mark-fyq/BEIDOU-project/README.md

# BEIDOU-project
一个神奇的计划！

天权-STM32最小核心系统板
