mark-fyq/BEIDOU-project/tianquan/V1.0/README-tianquan.md

# 项目介绍
一个STM32F103C8T6/STM32F103C6T6的超小型核心板，采用M.2-M接口，能够极大方便项目硬件移植以及简化电路设计。（仅成功烧录程序，未进行功能验证）

# 项目说明
* 已上传的文件包括核心板原理图、PCB、M.2接口的封装（AD）。  

# 注意事项
* 核心板打板请选择板厚==0.8mm==、绿色，并备注：不做半孔工艺（土豪无所谓）==PS：一般工艺都是焊盘镀锡，插拔次数有限！==
* 核心板PCB设计按照回流焊工艺（实际用热风枪吹），所以没有预留手焊空间。
* 有可能会出现PCB与原理图相差的地方，一切以PCB为准。
* 晶振要注意匹配电容不一定是12PF，购买时注意商家的备注。
* 轻触开关尺寸为3X4X2.5（应该没有比这个更小尺寸的得了）。
* 想重画PCB的注意M.2接口附近2mm内的TOP和BOTTOM层不做铺铜，防止因有可能的剐蹭造成的短路。

# 项目进度
* 原理设计（√）  
* LAYOUT设计（√）  
* PCB打板及焊接（√）
* 程序烧录验证（√）
* 转接底板设计
* 转接底板PCB打板及焊接
* 全功能及验证

# 核心板硬件功能
* SW下载接口
* 5V转3V3电源转换
* 串口转USB
* 16MBit SPI FLASH
* 电源、串口通信指示灯
* 复位按键

# 核心板实物图
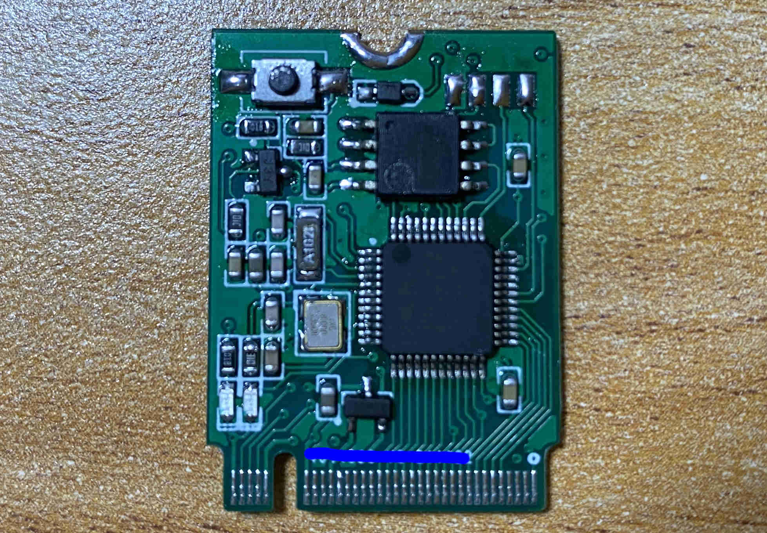
[picture p1: tianquan/V1.0/实物图/封面1.jpg]




# 附加说明
如有错误之处欢迎指正！
