mark-fyq/BEIDOU-project/tianquan/V1.0/实物图/原理图7.png

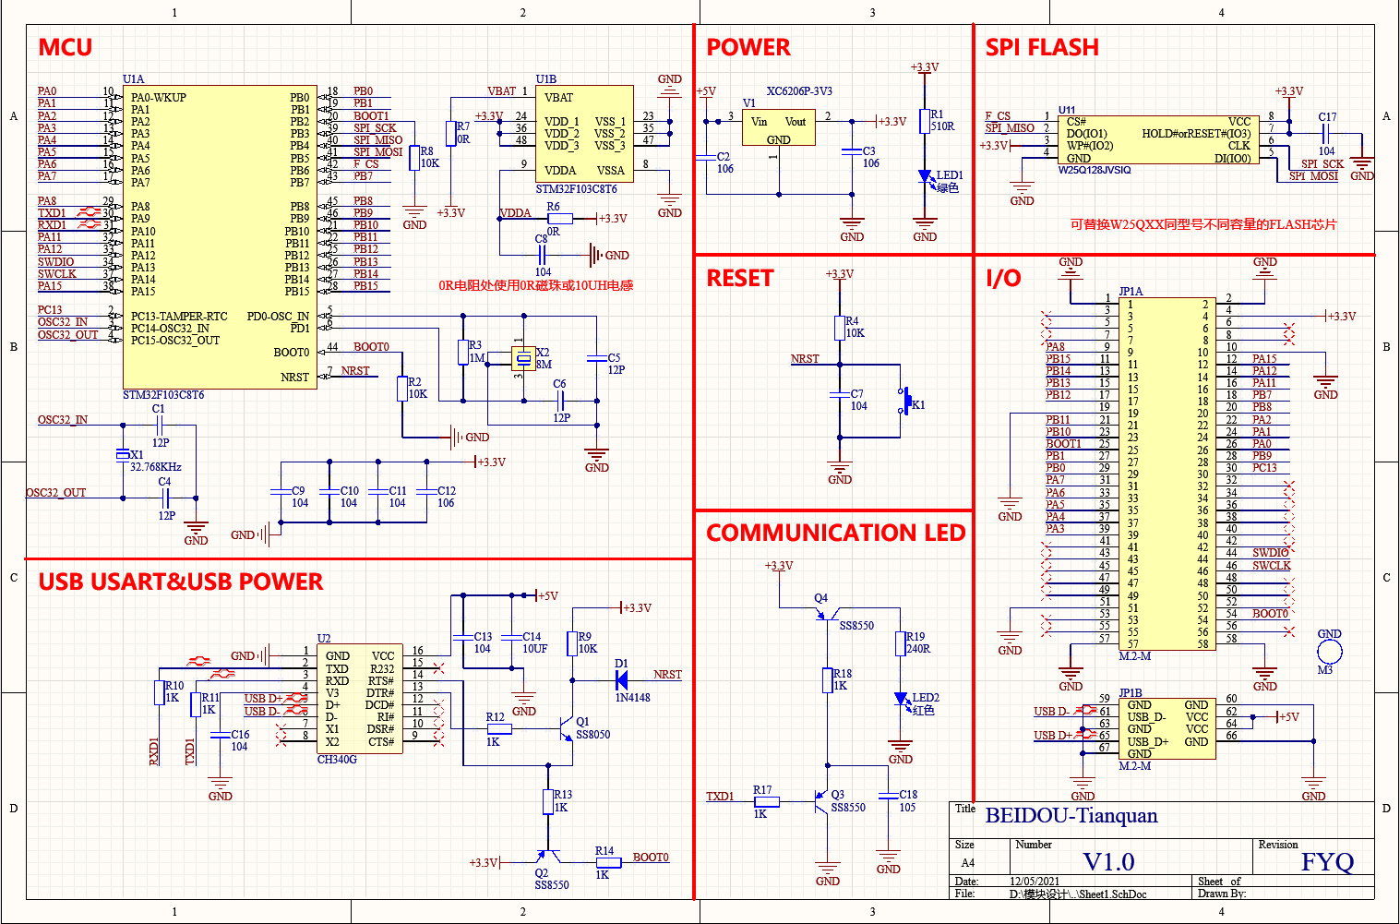
tianquan/V1.0/实物图/原理图7.png
