mark-fyq/BEIDOU-project/tianquan/V1.0/实物图/测试6.png

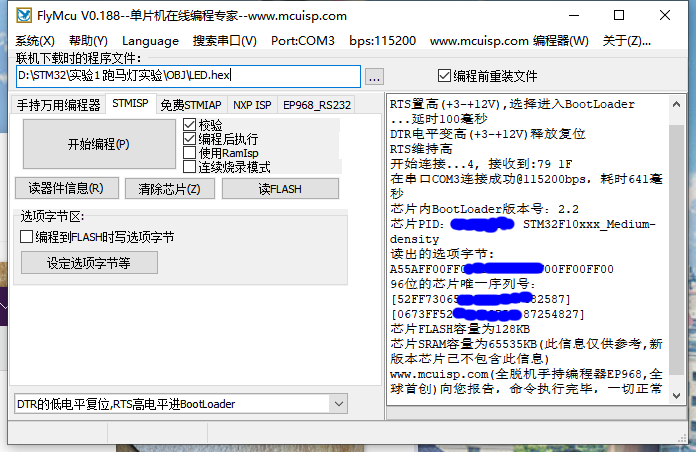
tianquan/V1.0/实物图/测试6.png
