mark-fyq/BEIDOU-project/tianquan/V1.0/实物图/烧录4.jpg

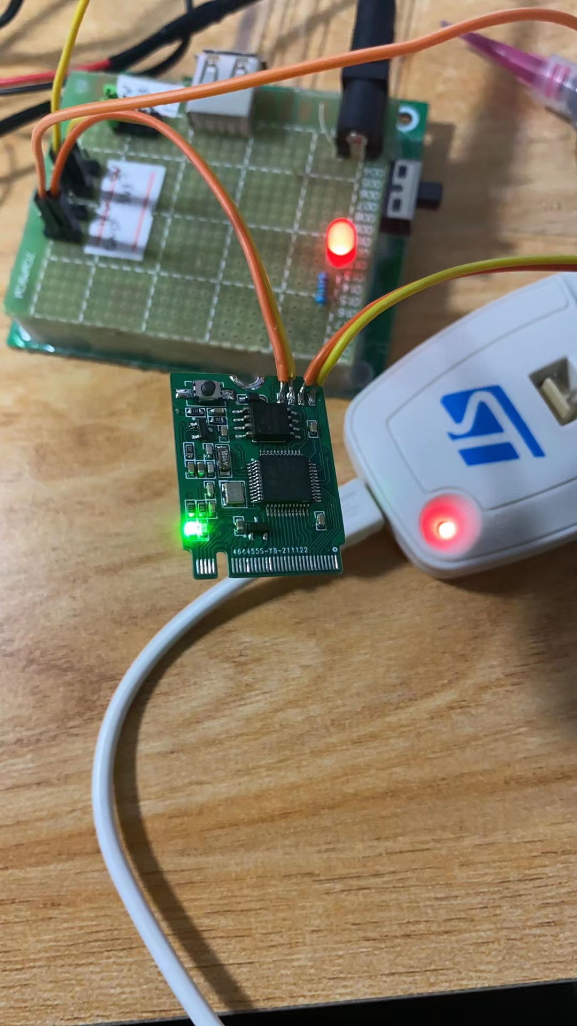
tianquan/V1.0/实物图/烧录4.jpg
