mark-fyq/BEIDOU-project/(list of files, drawings)

Other design files:
tianquan/V1.0/原理图、PCB/Sheet1.SchDoc
tianquan/V1.0/原理图、PCB/拓展板.PcbDoc
tianquan/V1.0/原理图、PCB/拓展板.SchDoc
tianquan/V1.0/自定义封装/M.2封装.PcbLib
tianquan/V1.0/自定义封装/M.2接口.SchLib
