mark-fyq/BEIDOU-project/(commit log)

2021-11-27 add tianquanv1.0
    [M.2封装.PcbLib, M.2接口.SchLib, Sheet1.SchDoc]
2021-11-29 revise sheet and PCB
    [Sheet1.SchDoc]
